OlehNaKone/electronic-kicad-user-lib/README.md

# kicad-user-lib

SSD1306-128x64_OLED copied from https://github.com/pforrmi/KiCad-SSD1306-128x64
